matiasmicheletto/DomeController/Hardware/DomeController_3DView.png

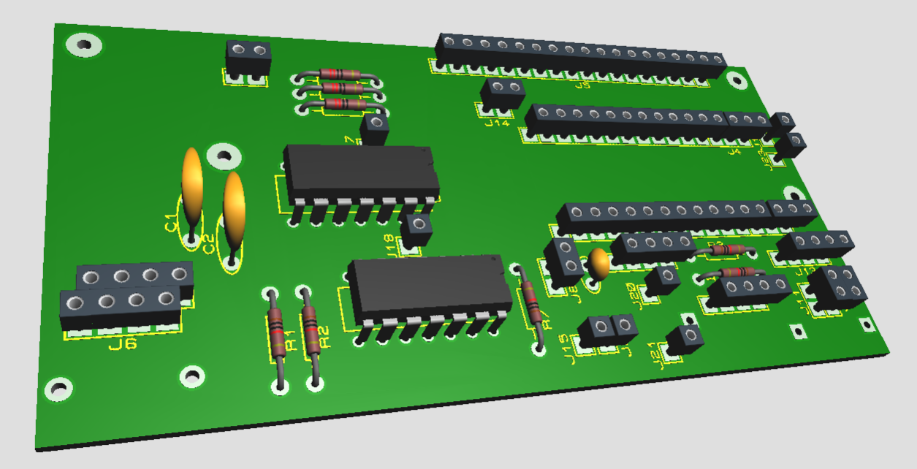
Hardware/DomeController_3DView.png
