matiasmicheletto/DomeController/Hardware/DomeController_PCB.png

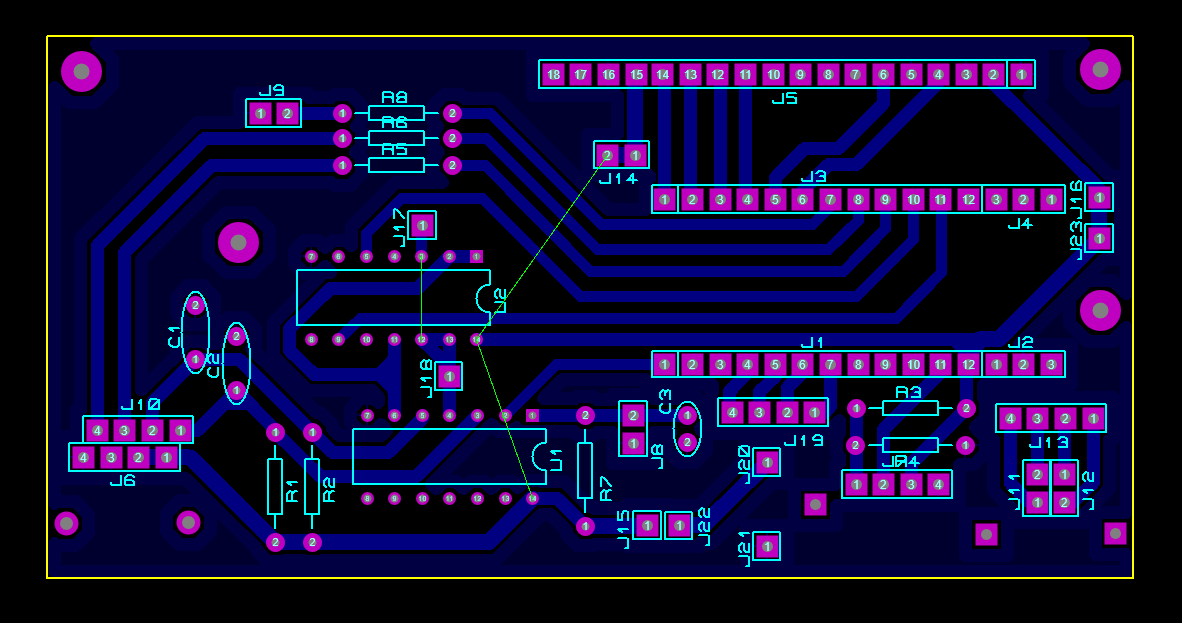
Hardware/DomeController_PCB.png
