matiasmicheletto/DomeController/Hardware/DomeController_Schematic.bmp

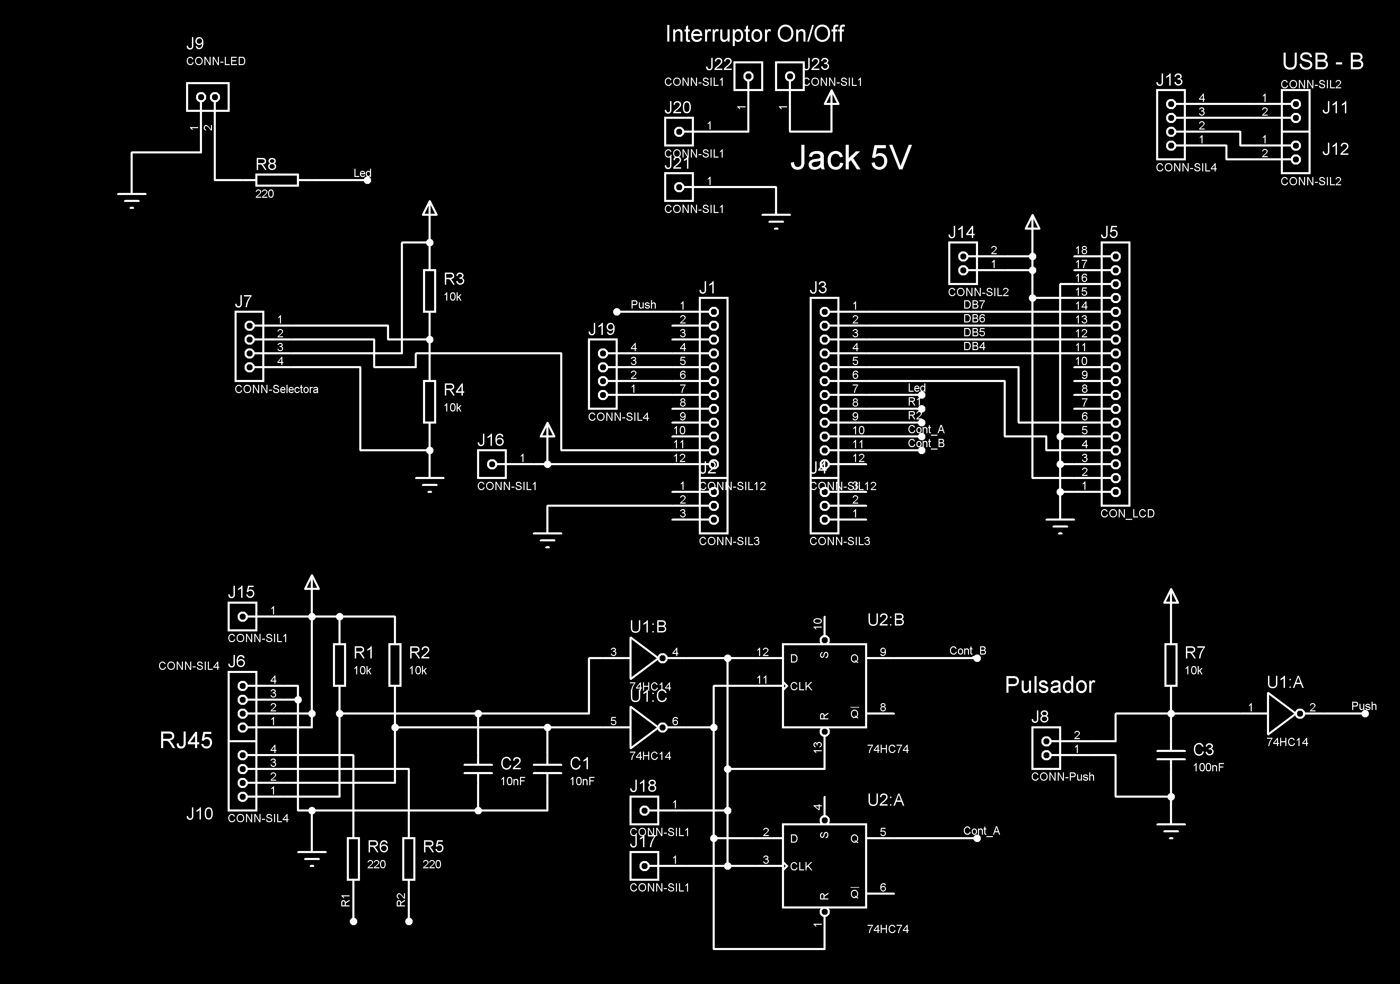
Hardware/DomeController_Schematic.bmp
