matiasmicheletto/DomeController/Hardware/HBridge_3dView.png

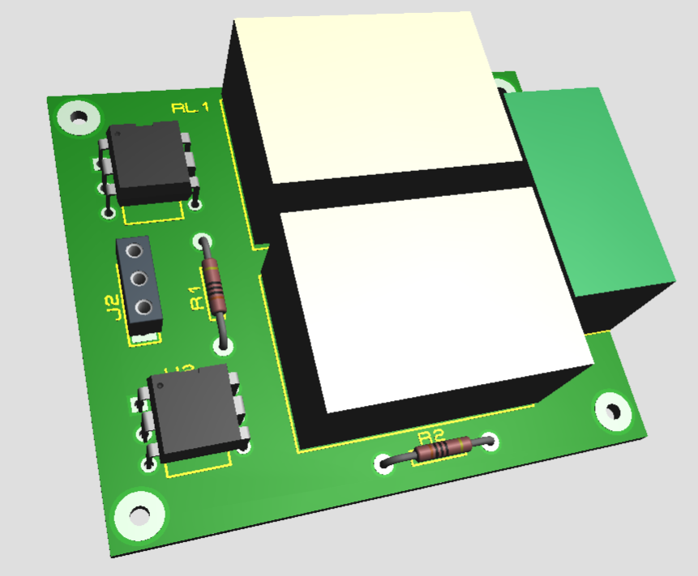
Hardware/HBridge_3dView.png
