matiasmicheletto/DomeController/Hardware/HBridge_PCB.png

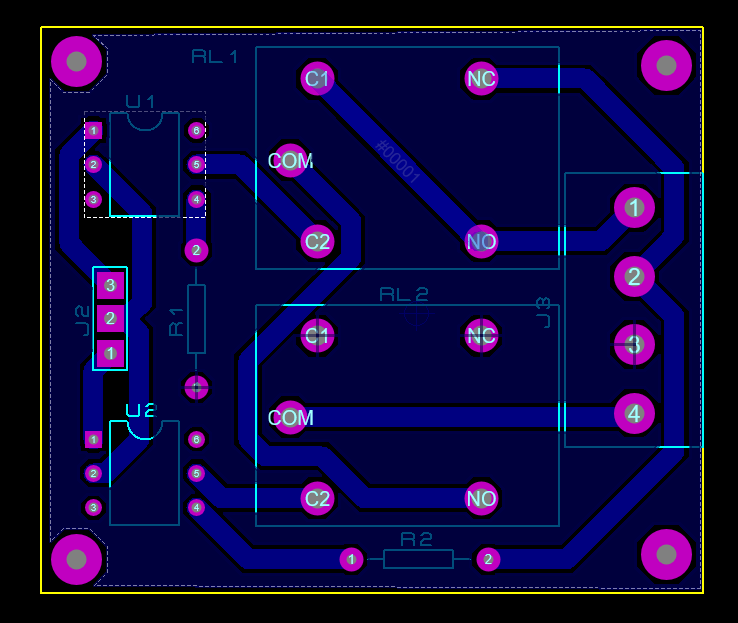
Hardware/HBridge_PCB.png
