matiasmicheletto/DomeController/Hardware/HBridge_Schematic.bmp

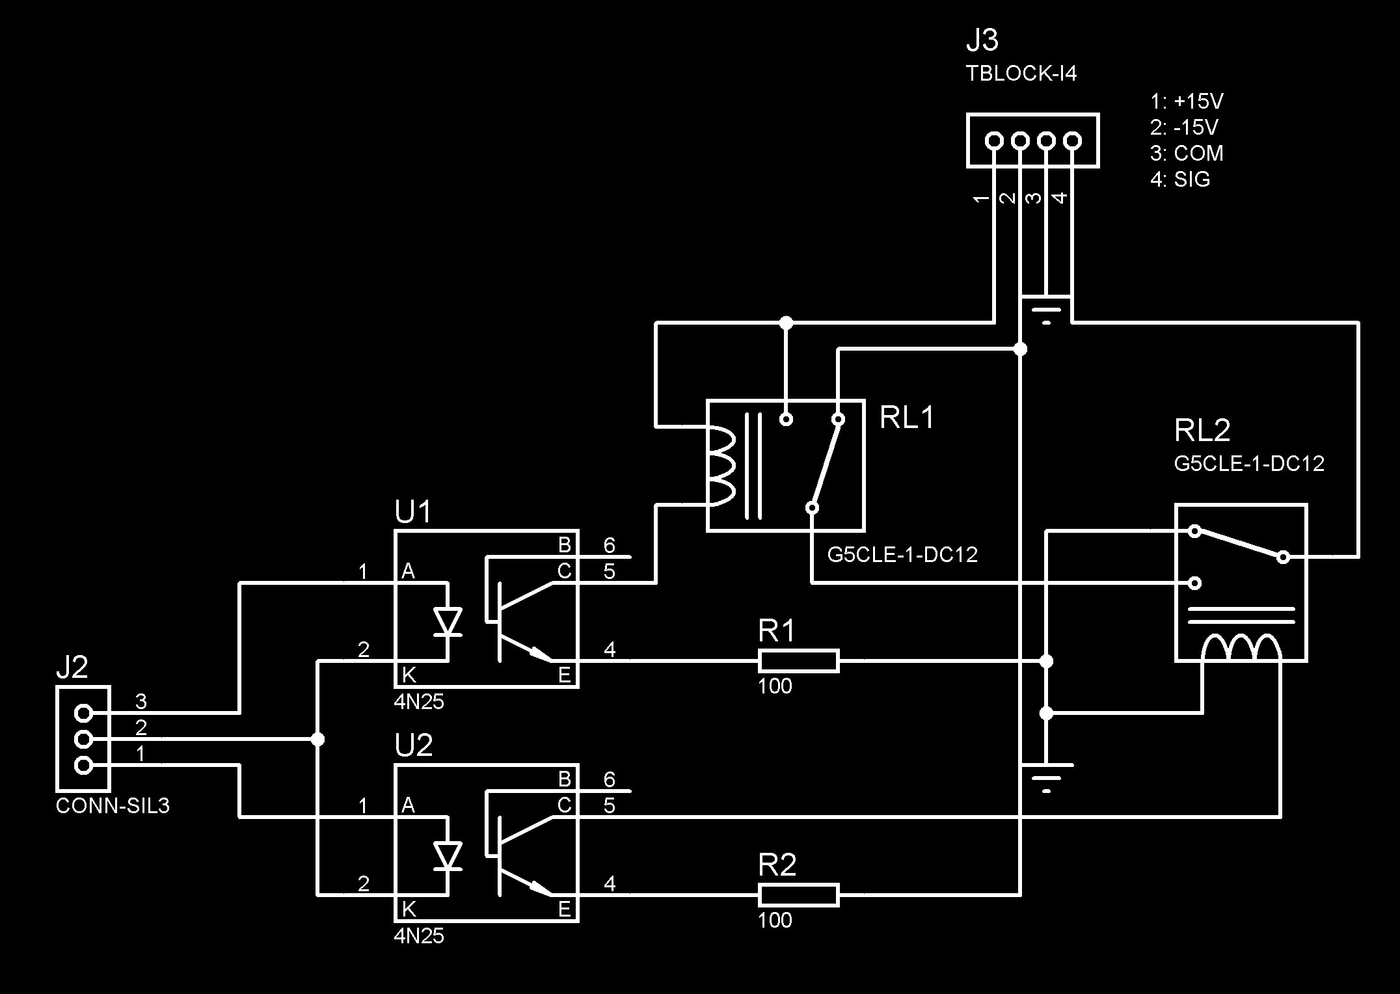
Hardware/HBridge_Schematic.bmp
