matiasmicheletto/DomeController/(list of files, drawings)

Other design files:
Hardware/DomeController.pdsprj
Hardware/HBridge.pdsprj
